joostbooy/MidiCvSequencer/Src/Engine/midiBuffer.h

#ifndef MidiBuffer_h
#define MidiBuffer_h

#include "midiEvent.h"
#include "que.h"

class MidiBuffer {

public:

	struct Reading {
		uint8_t data;
		uint32_t time;
	};

	Que<Reading, 64> in_que;
	Que<uint8_t, 64> out_que;
	Que<uint8_t, 8> clock_out_que;

	void init(int port_index) {
		num_data_bytes_ = 0;
		last_message_ = 0x00;

		event.port = port_index;
		clock_event.port = port_index;

		MidiEvent::set_source(&event, MidiEvent::PORT, port_index);
		MidiEvent::set_source(&clock_event, MidiEvent::PORT, port_index);
	}

	void write_out(MidiEvent::Event *event) {
		if (event->message == last_message_) {
			force_write_out(event, 2);
		} else {
			last_message_ = event->message;
			force_write_out(event, 3);
		}
	}

	bool write_out_non_blocking(MidiEvent::Event *event) {
		size_t available = out_que.available_size();
		uint8_t requested = event->message != last_message_ ? 3 : 2;

		if (available >= requested) {
			if (requested == 3) {
				last_message_ = event->message;
				out_que.write(event->message);
			}
			out_que.write(event->data[0]);
			out_que.write(event->data[1]);
			return true;
		}
		return false;
	}

	bool event_received(MidiEvent::Event &e) {
		while (in_que.readable()) {
			Reading reading = in_que.read();

			if (reading.data >= 0xF8) {
				clock_event.message = reading.data;
				clock_event.time = reading.time;
				e = clock_event;
				return true;
			}

			if (parse(reading.data, reading.time) == true) {
				e = event;
				return true;
			}
		}
		return false;
	}

private:
	MidiEvent::Event event;
	MidiEvent::Event clock_event;

	uint8_t num_data_bytes_;
	uint8_t last_message_;


	void force_write_out(MidiEvent::Event *event, const size_t size) {
		while (out_que.available_size() < size);

		if (size == 3) {
			out_que.write(event->message);
		}

		out_que.write(event->data[0]);
		out_que.write(event->data[1]);
	}

	bool parse(uint8_t reading, uint32_t time) {
		if (reading >= 0x80) {
			event.message = reading;
			num_data_bytes_ = 0;
		} else {
			event.data[num_data_bytes_] = reading;
			++num_data_bytes_;

			if (num_data_bytes_ >= 2) {
				num_data_bytes_ = 0;
				event.time = time;
				return true;
			}
		}
		return false;
	}
};

#endif
