joostbooy/MidiCvSequencer/(commit log)

2023-10-08 fixed file load issue
    [cvInput.h]
2023-10-18 calibrationPage can now overtake cvOutputEngine
2023-10-20 improved Dac calibration
2023-10-23 added send pitch bend
2023-10-26 changed leds in grouped shift mode
2023-10-31 we now enter random mode with shift & mute buttons
2023-11-02 fixed wrong interger type
    [repeatEngine.h]
2023-11-02 fixed repeat spread not being able to center
    [drumTrack.cpp, noteTrack.cpp, repeatEngine.h]
2023-11-03 fixed scrollbar not dissepearing
    [pianoRollPainter.h]
2023-11-20 added small track name
2023-11-28 inverted adc reading
2023-11-29 name change & placed timer bitmap higher
2023-12-01 clear ui que after disk read/write
2023-12-02 fixed message not being visible
    [textInputPage.h]
2023-12-02 fixed pattern label generation
    [baseTrack.cpp, baseTrack.h, trackData.cpp]
2023-12-02 changed led colors
2023-12-02 added repeat velocity modes
2023-12-03 removed chord track painter
2023-12-03 made led painter static
2023-12-04 refined repeat velocity
2023-12-04 fixed pattern select on deletion
    [patternListPage.h]
2023-12-05 enable clear led
2023-12-06 fixed incorrect pattern select on deletion
    [patternListPage.h]
2023-12-12 use x & y encoders to select a char
2023-12-16 fix incorrect usb status
    [midiPort.h]
2023-12-17 keep track of usb data
2023-12-19 send notes off when clearing que
2023-12-21 changed velocity value
2023-12-21 made reset interrupt safe
    [midiInputEngine.h]
2023-12-21 fix cc data format
    [cvInputEngine.h]
2023-12-24 replaced modes longer than 16 steps
    [positionEngine.h]
2023-12-24 fix midi uart 4 send & receive
    [midiPort.h]
2023-12-27 added track list
2023-12-27 print small track name in header
2023-12-27 save & load track list
2023-12-28 save & load track index
2023-12-29 swap solo mute bits when swapping tracks
    [song.h]
2024-01-03 fixed track type list swap
    [song.h]
2024-01-03 deprecated track list
2024-01-03 paint footer leds
2024-01-03 fixed invalid cc send
    [cvInputEngine.h]
2024-01-03 fixed song name not being loaded
    [song.cpp]
2024-01-04 write kb instead of bytes to prevent overflow
    [diskNavigatorPage.h, uiText.h]
2024-01-04 added curve track step shift
2024-01-04 added schematics
2024-01-04 fixed incorrect array indexing
    [cvInputEngine.h, engine.cpp]
2024-01-05 fixed last message not clearing
    [midiPort.h]
2024-01-05 reset pages on settings load
    [loadPage.h]
2024-01-05 fixed incorrect note names in random page
    [noteRandomPage.h]
2024-01-05 fixed incorrect midi source
    [midiBuffer.h]
2024-01-05 added lower case chars to large font
2024-01-06 draw step value on encoder click
2024-01-06 fixed step value not showing
    [drumPainter.h]
2024-01-07 indicate port with step encoder led
2024-01-07 led indicate useable controls
2024-01-07 removed edit led painting
2024-01-07 optimized calibration value reading
2024-01-07 center bend on reset
    [cvOutputEngine.h]
2024-01-07 fixed semi note value
    [calibration.h]
